DanielJC1/fse-dimmer-wifi/(commit log)

2026-10-29 Arduino files
2026-10-29 diagrama de conexiones
